taylorlaekeman/copper_chef/res/ac.png

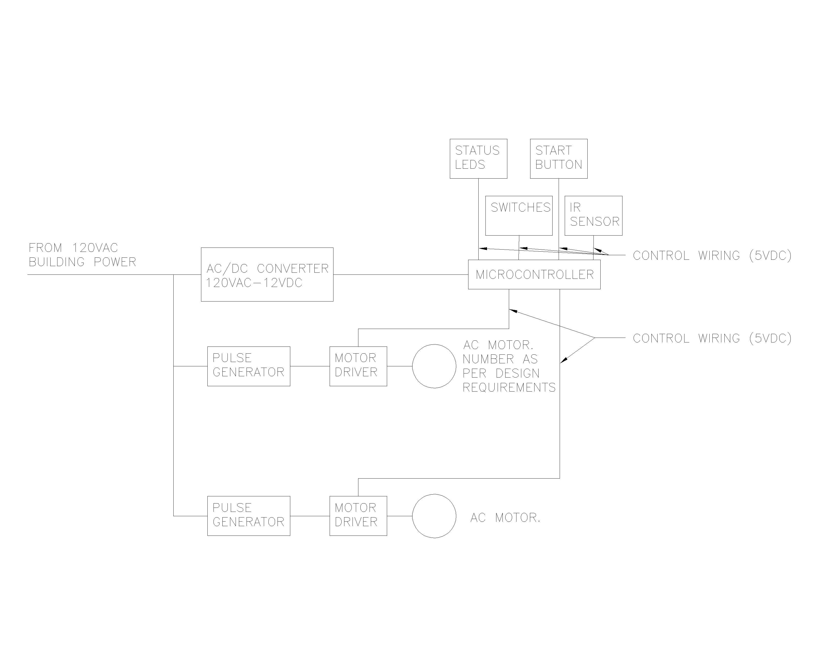
res/ac.png
