taylorlaekeman/copper_chef/res/belt.png

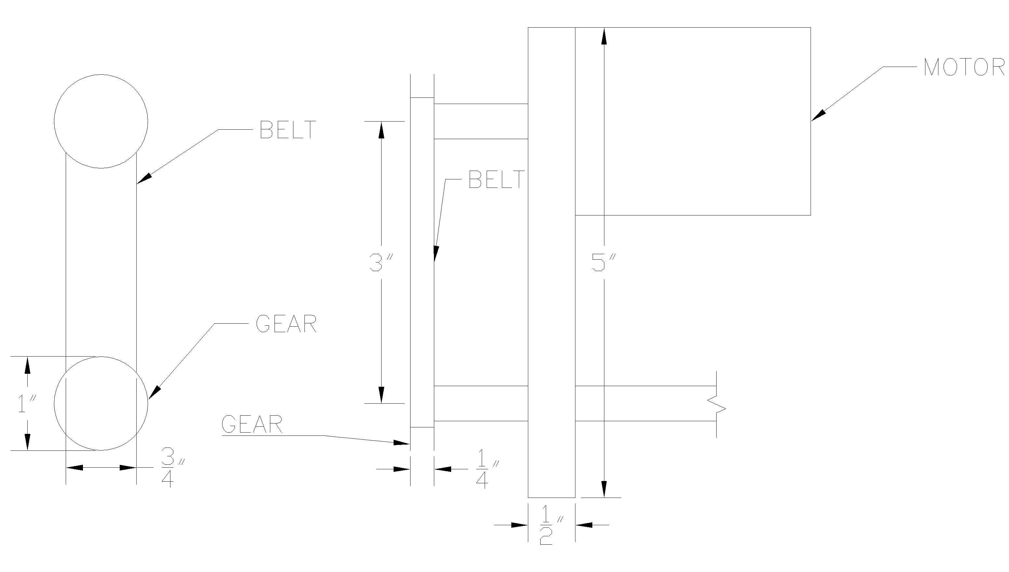
res/belt.png
