taylorlaekeman/copper_chef/res/bevel_gear.png

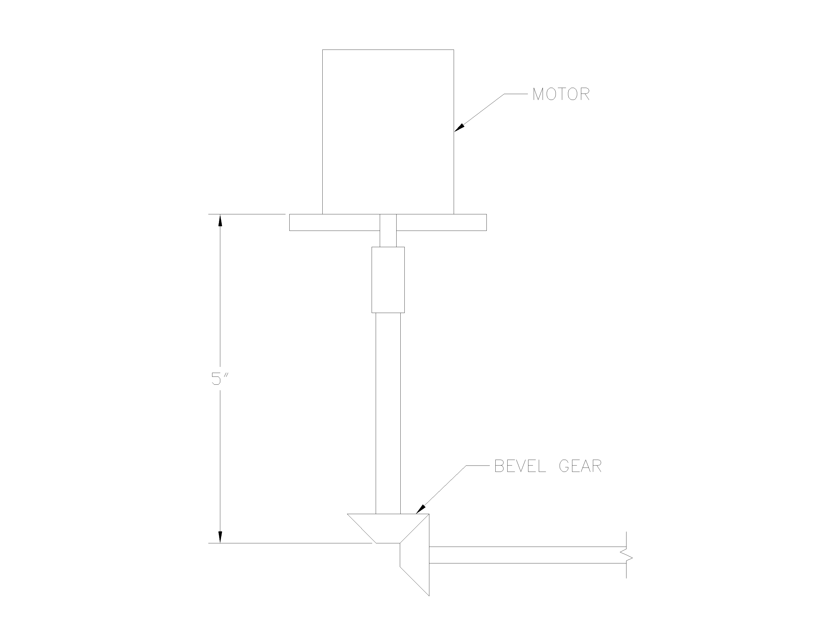
res/bevel_gear.png
