taylorlaekeman/copper_chef/res/cage.png

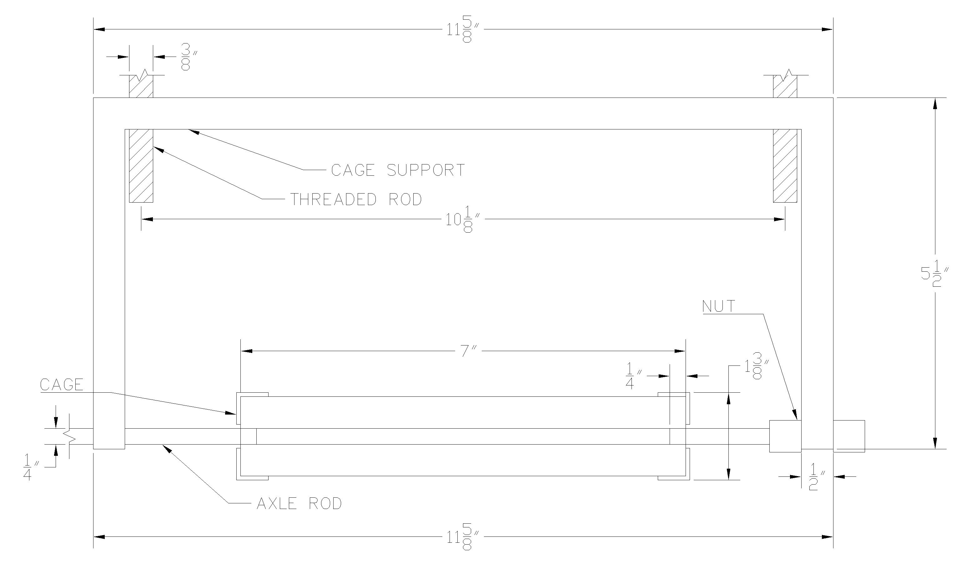
res/cage.png
