taylorlaekeman/copper_chef/res/cage_axle.png

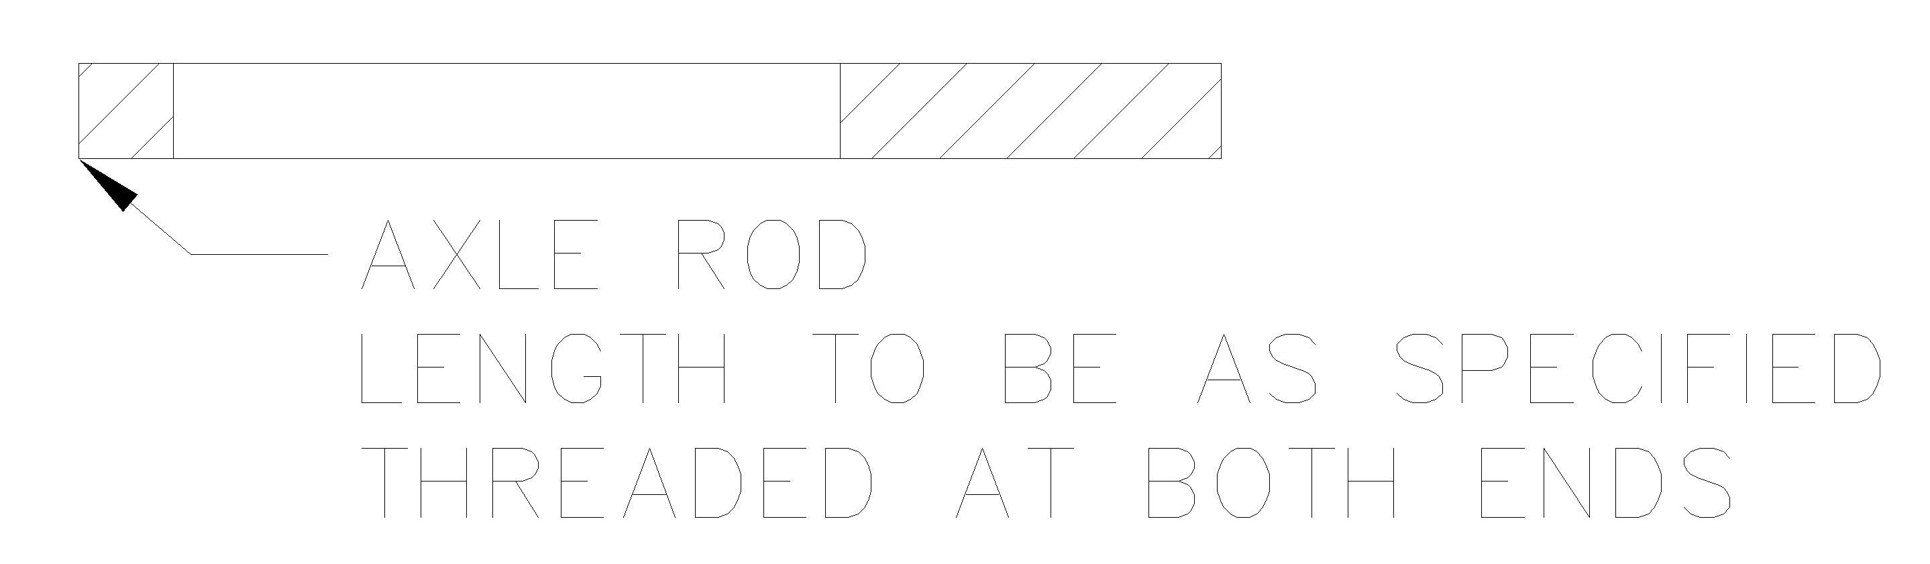
res/cage_axle.png
