taylorlaekeman/copper_chef/res/cage_ball_screw_adapter.png

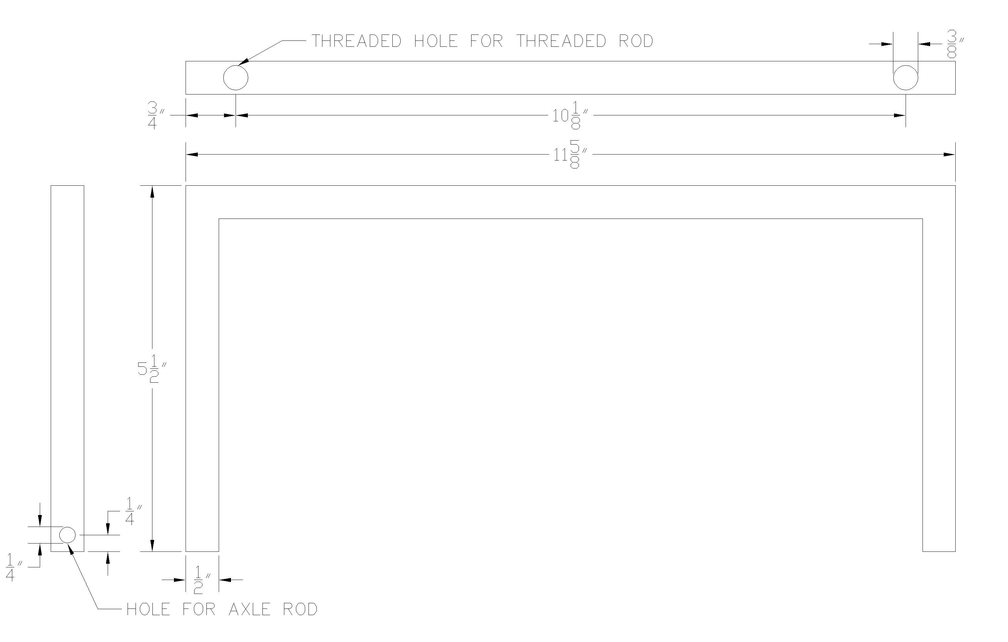
res/cage_ball_screw_adapter.png
