taylorlaekeman/copper_chef/res/cage_bar.png

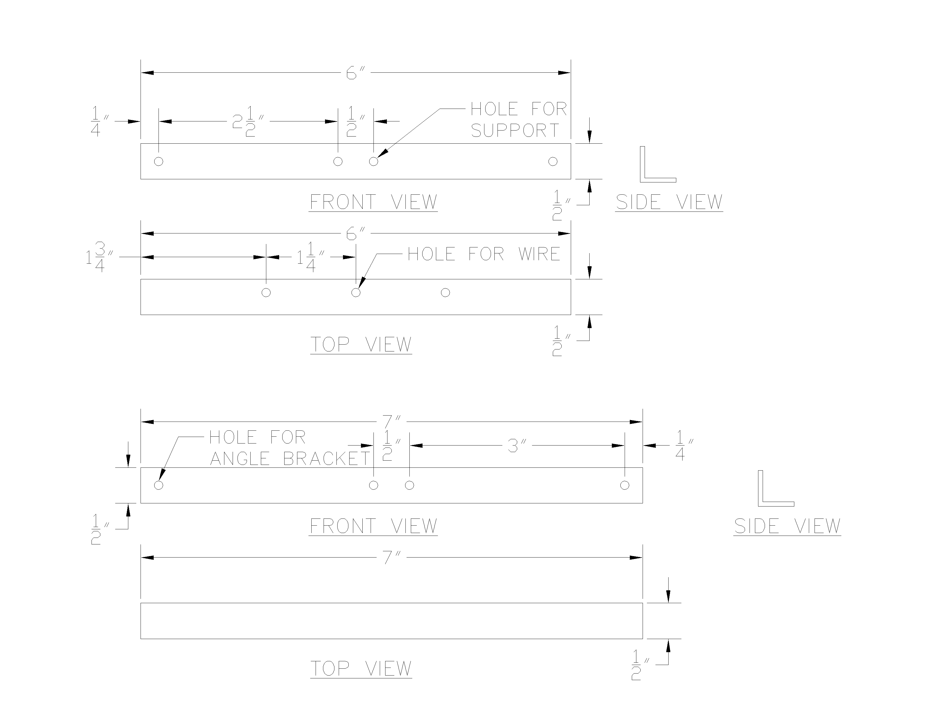
res/cage_bar.png
