taylorlaekeman/copper_chef/res/cage_basket.png

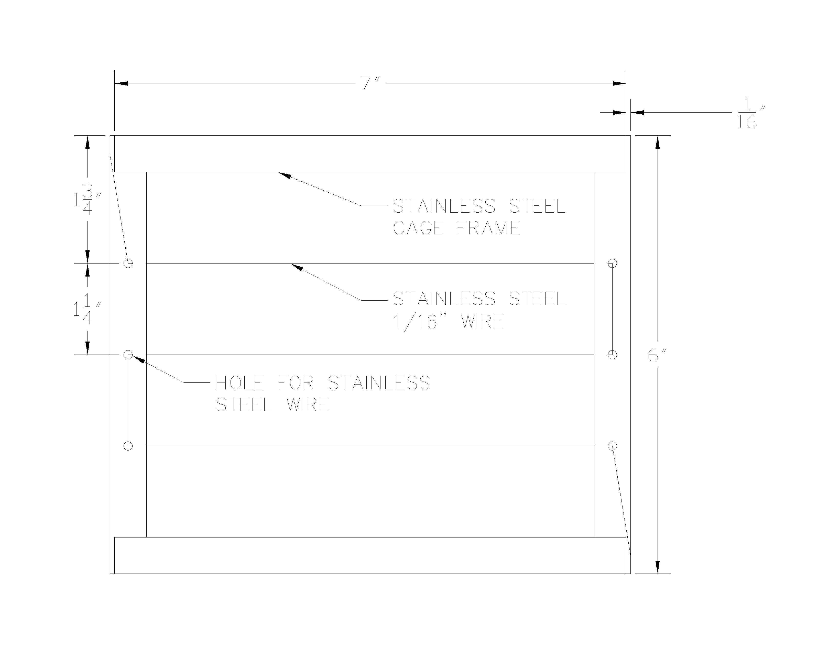
res/cage_basket.png
