taylorlaekeman/copper_chef/res/cage_coupling.png

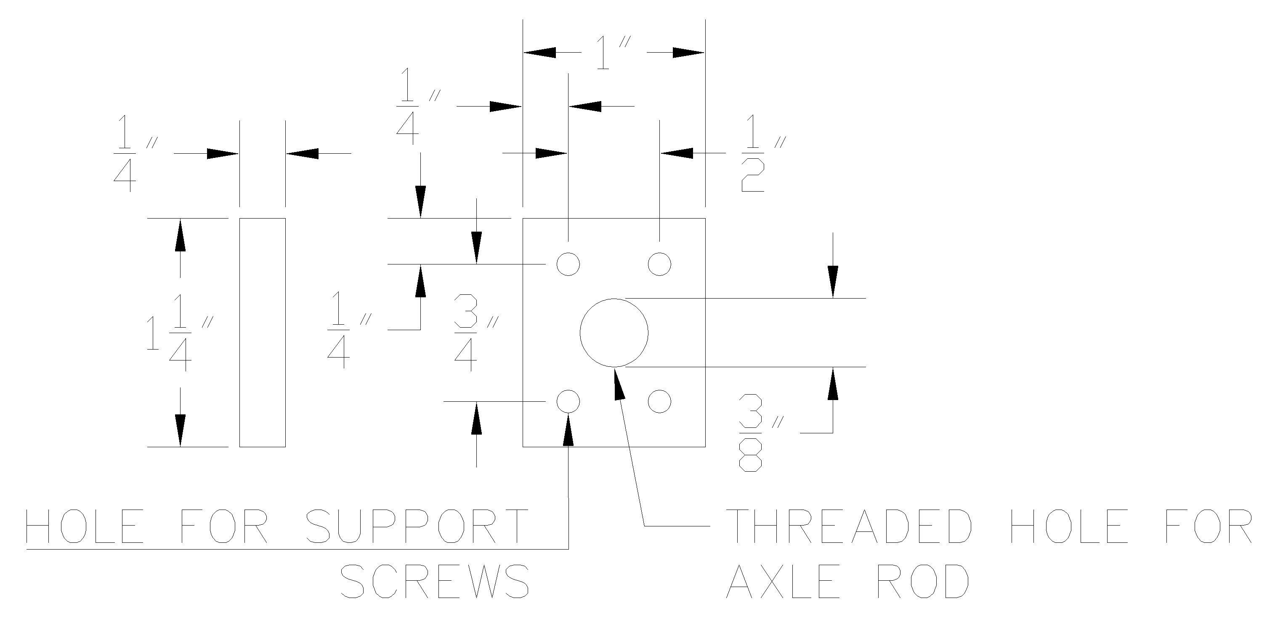
res/cage_coupling.png
