taylorlaekeman/copper_chef/res/dc.png

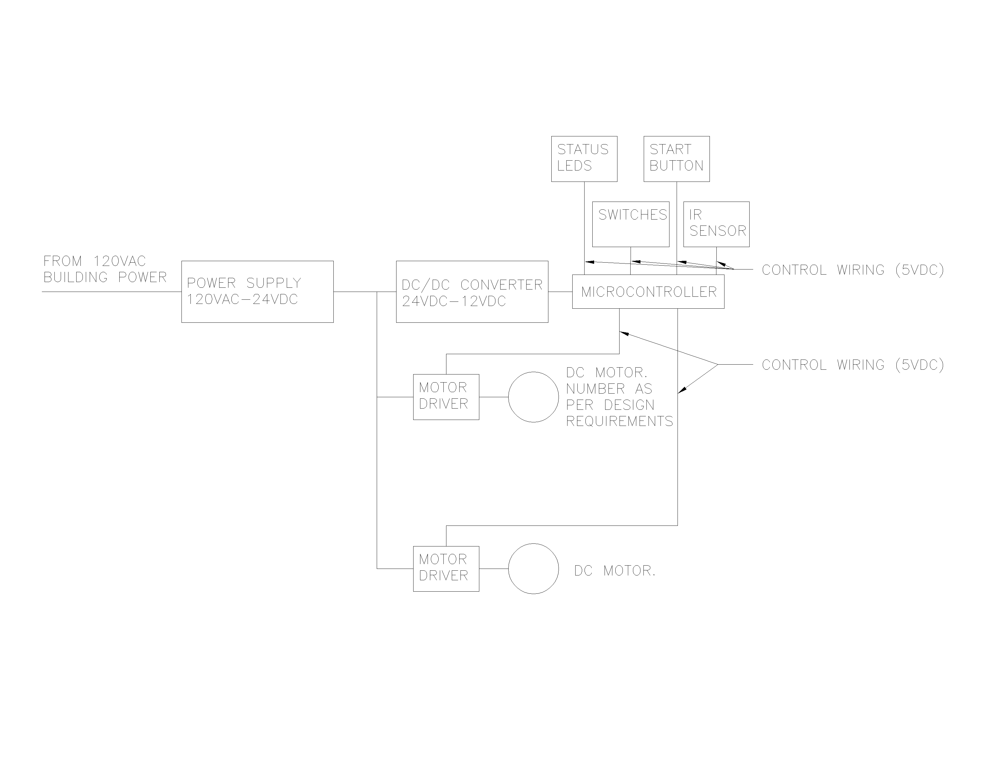
res/dc.png
