taylorlaekeman/copper_chef/res/gear_rack.png

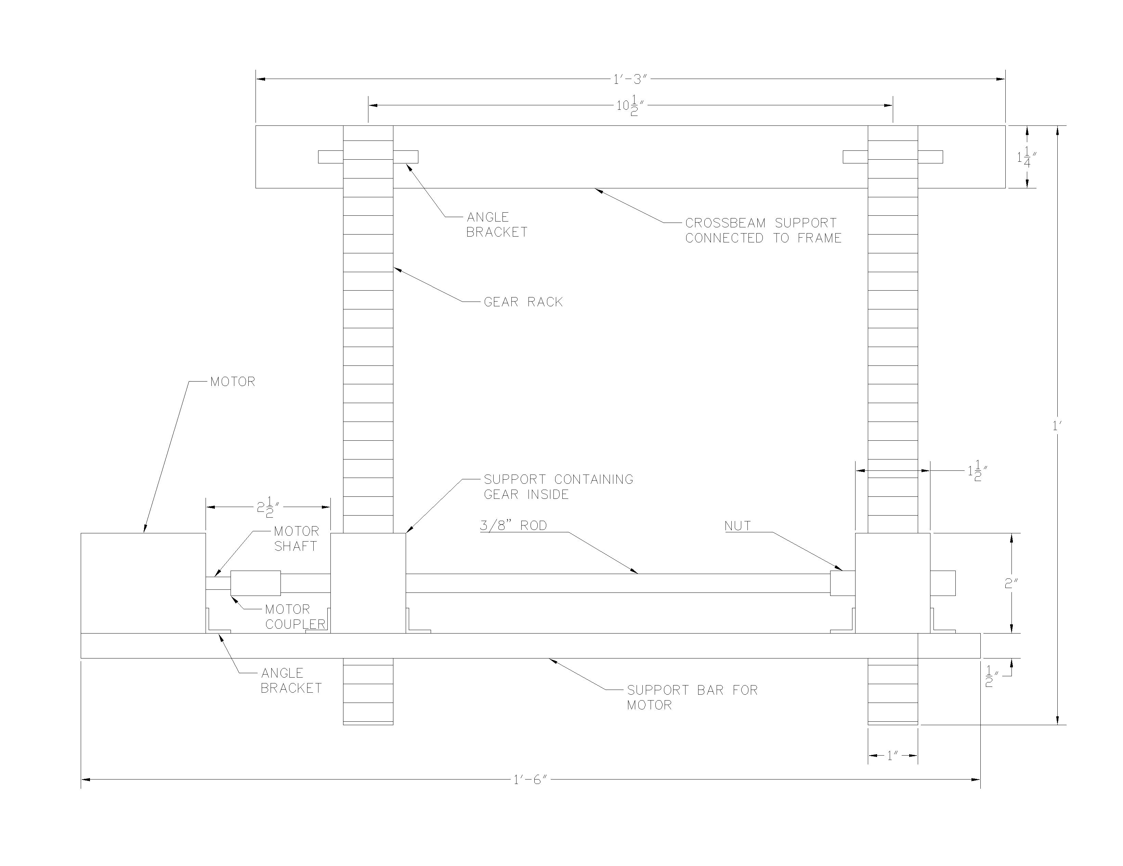
res/gear_rack.png
