taylorlaekeman/copper_chef/res/gear_rack_crossbeam.png

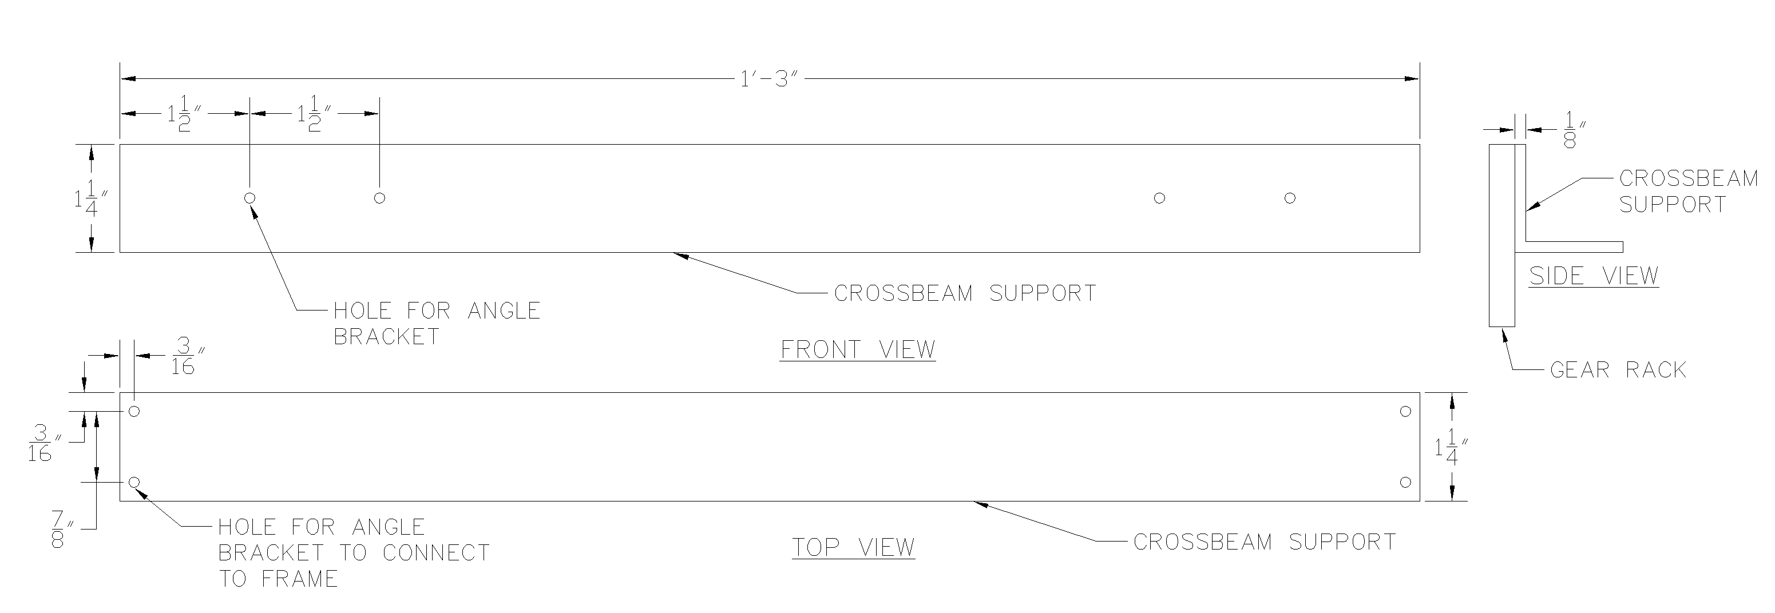
res/gear_rack_crossbeam.png
