taylorlaekeman/copper_chef/res/gear_rack_support.png

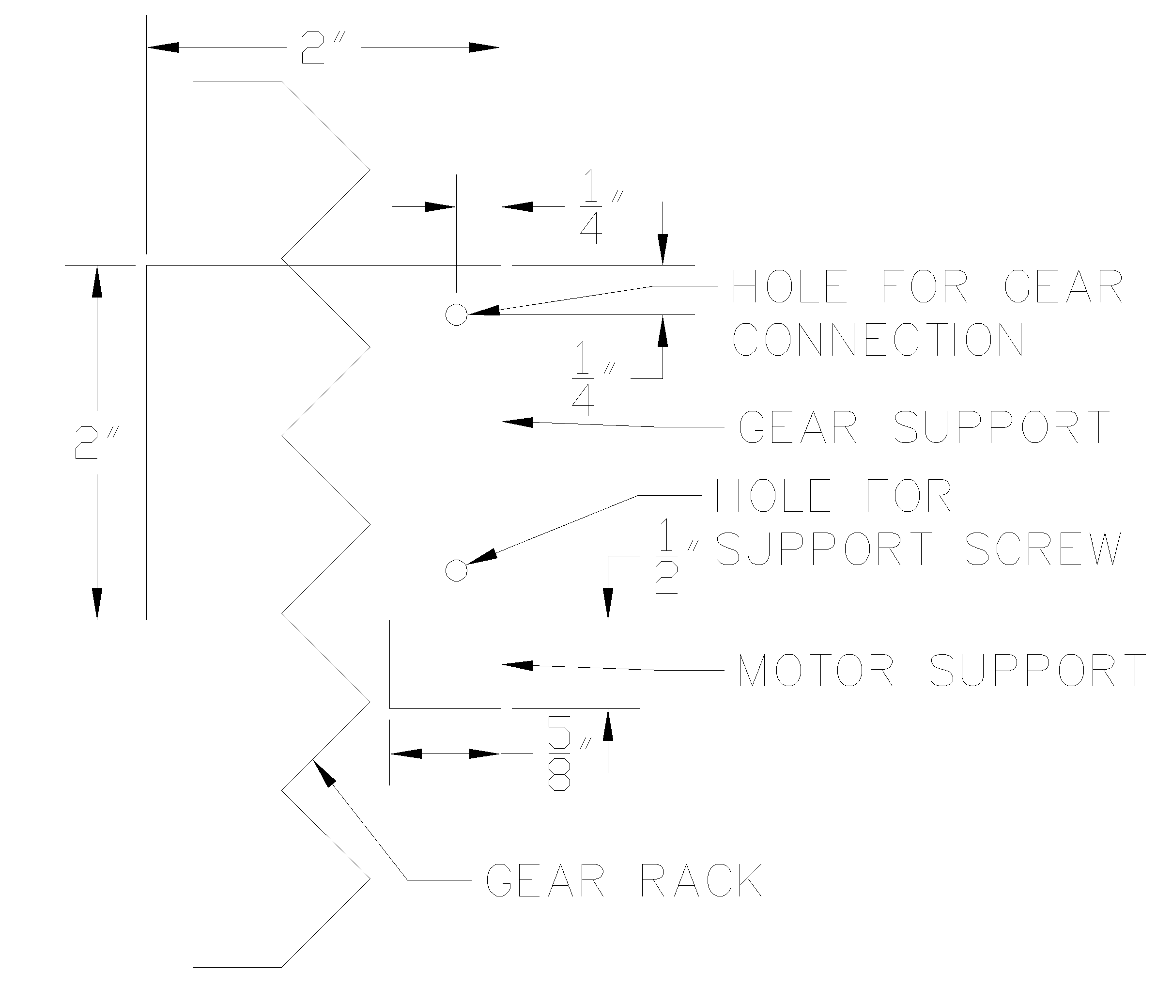
res/gear_rack_support.png
