taylorlaekeman/copper_chef/res/gear_rack_support_flat_bar.png

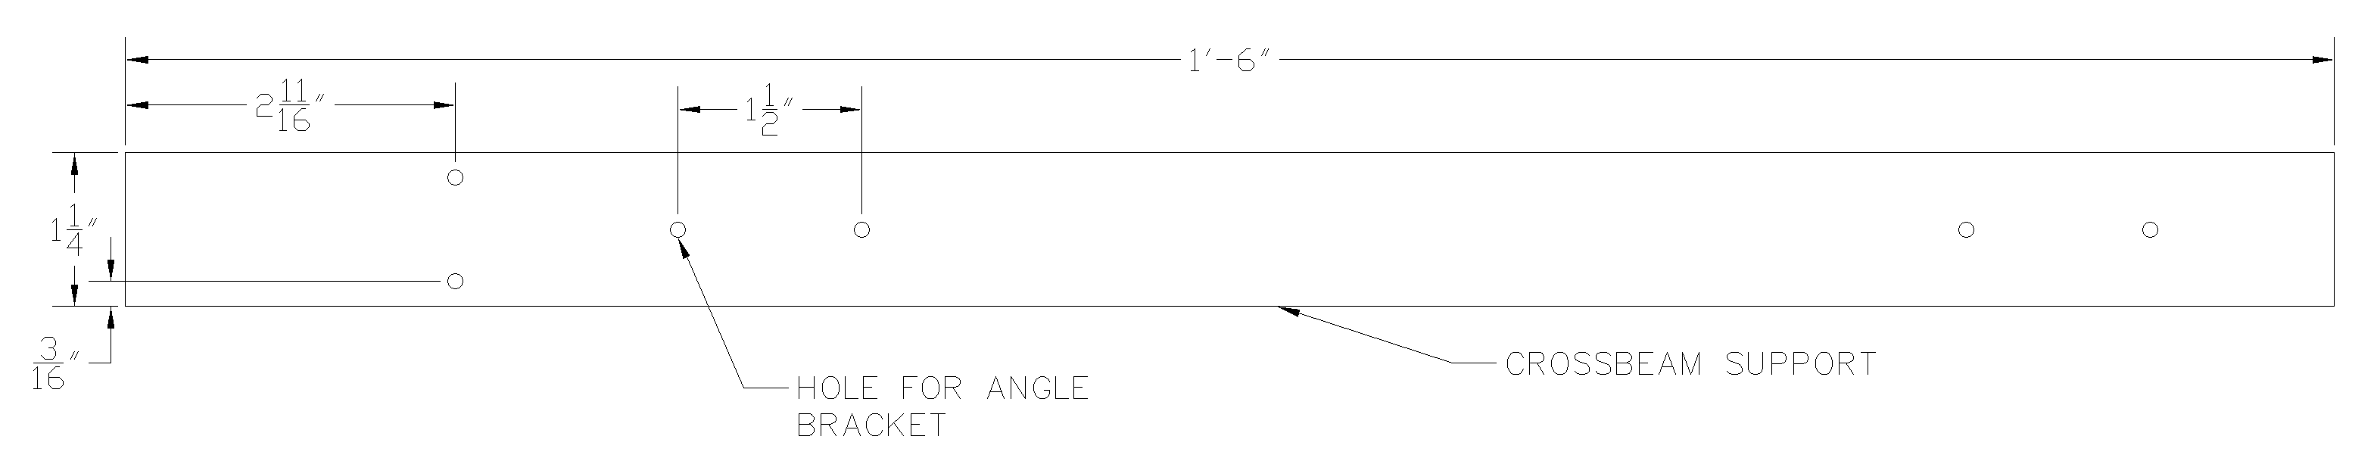
res/gear_rack_support_flat_bar.png
