taylorlaekeman/copper_chef/res/mesh.png

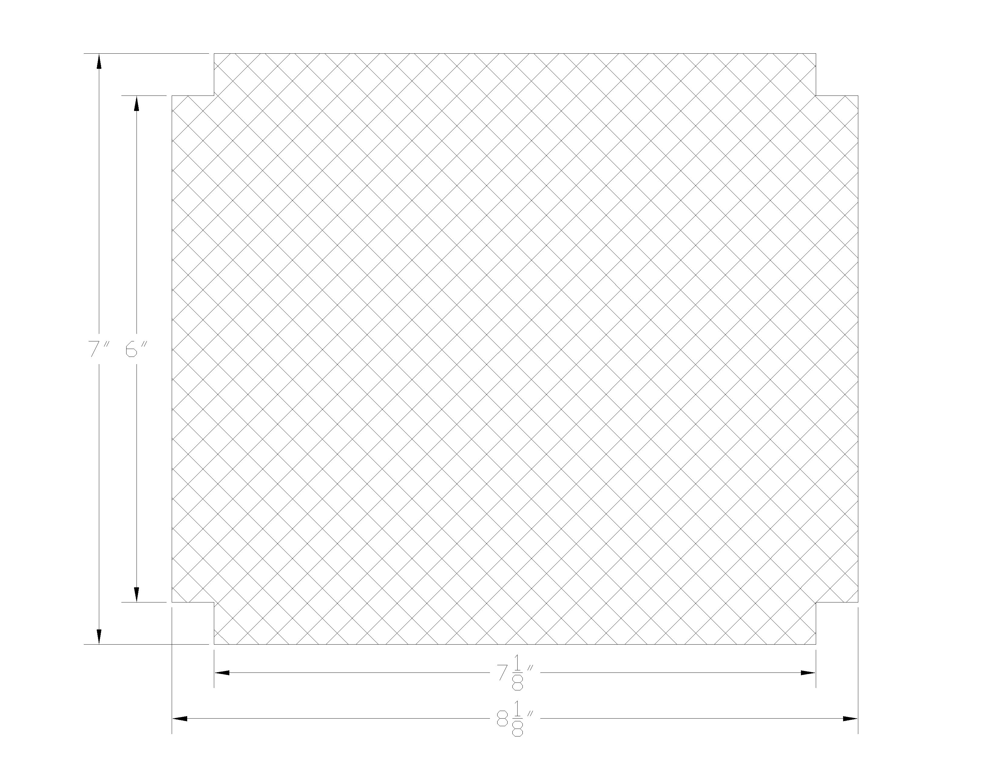
res/mesh.png
