taylorlaekeman/copper_chef/res/sensor.png

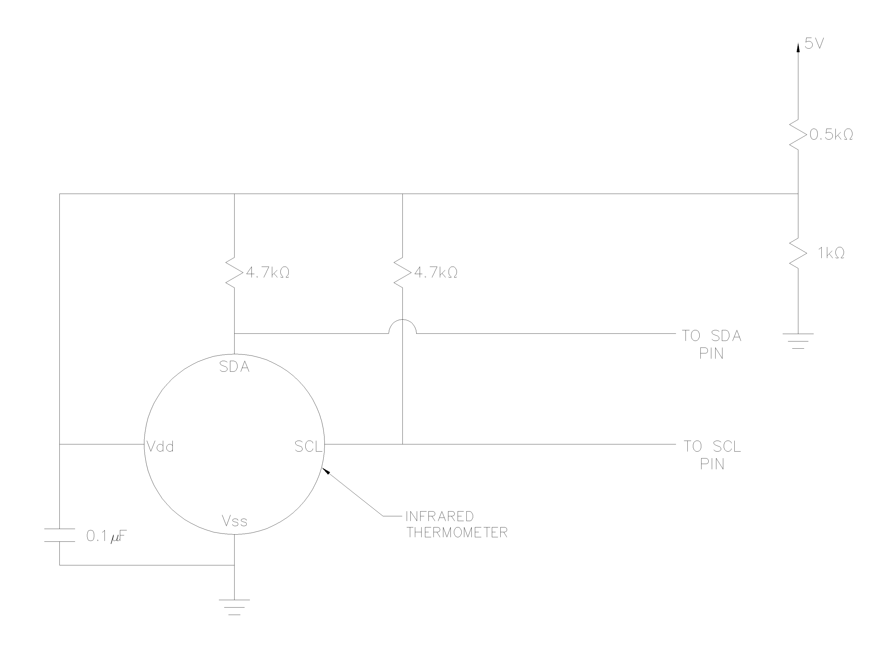
res/sensor.png
