taylorlaekeman/copper_chef/res/sensor_accuracy.png

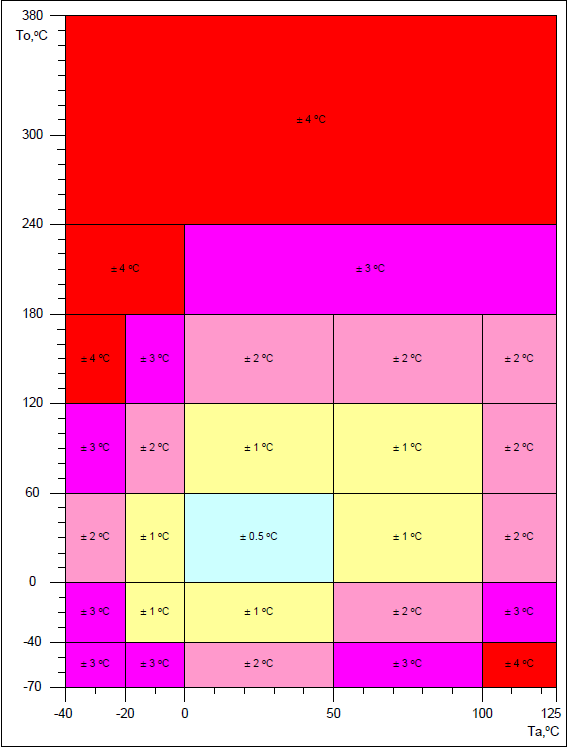
res/sensor_accuracy.png
