taylorlaekeman/copper_chef/res/spatula.png

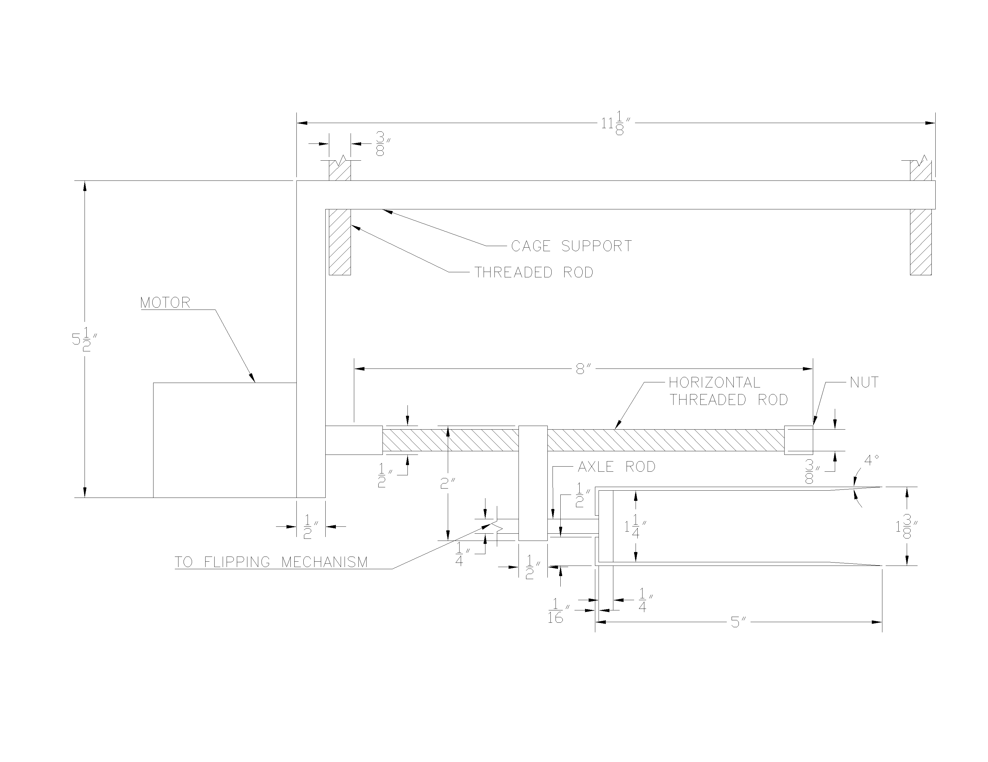
res/spatula.png
