taylorlaekeman/copper_chef/res/spatula_coupling.png

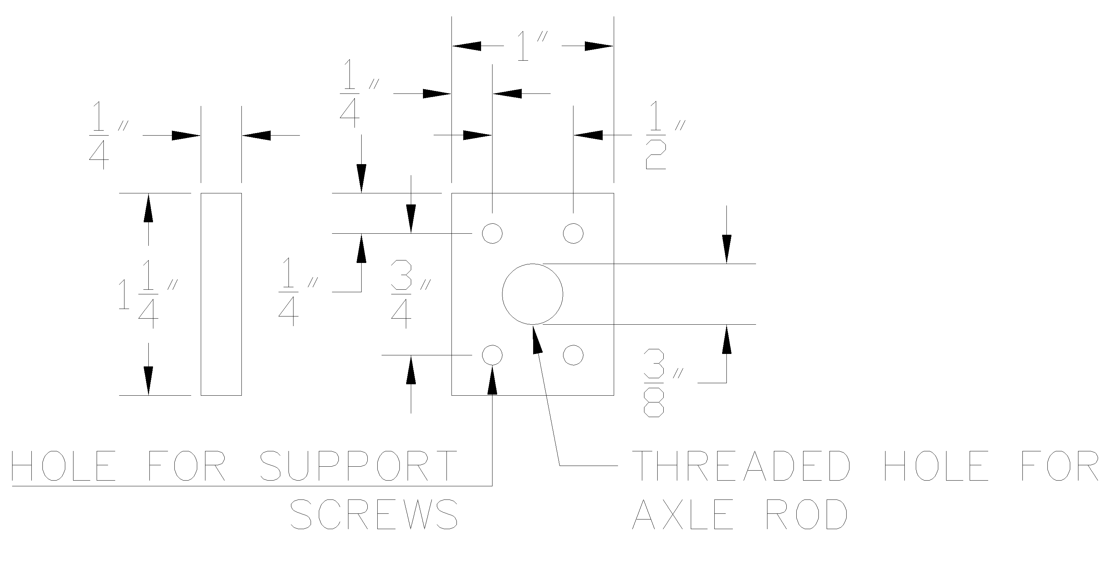
res/spatula_coupling.png
