taylorlaekeman/copper_chef/res/spatula_horizontal_coupling.png

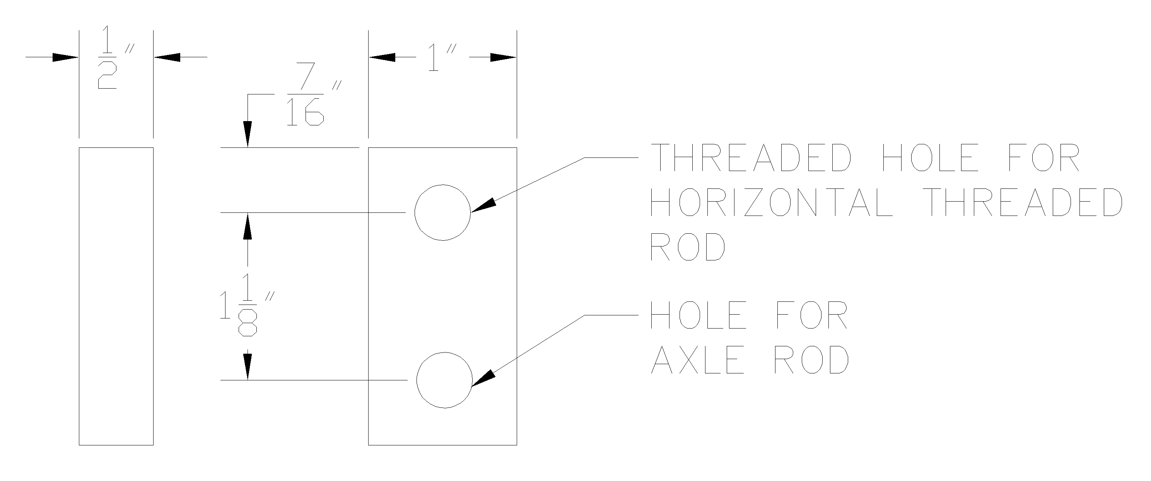
res/spatula_horizontal_coupling.png
