taylorlaekeman/copper_chef/res/spatula_plate.png

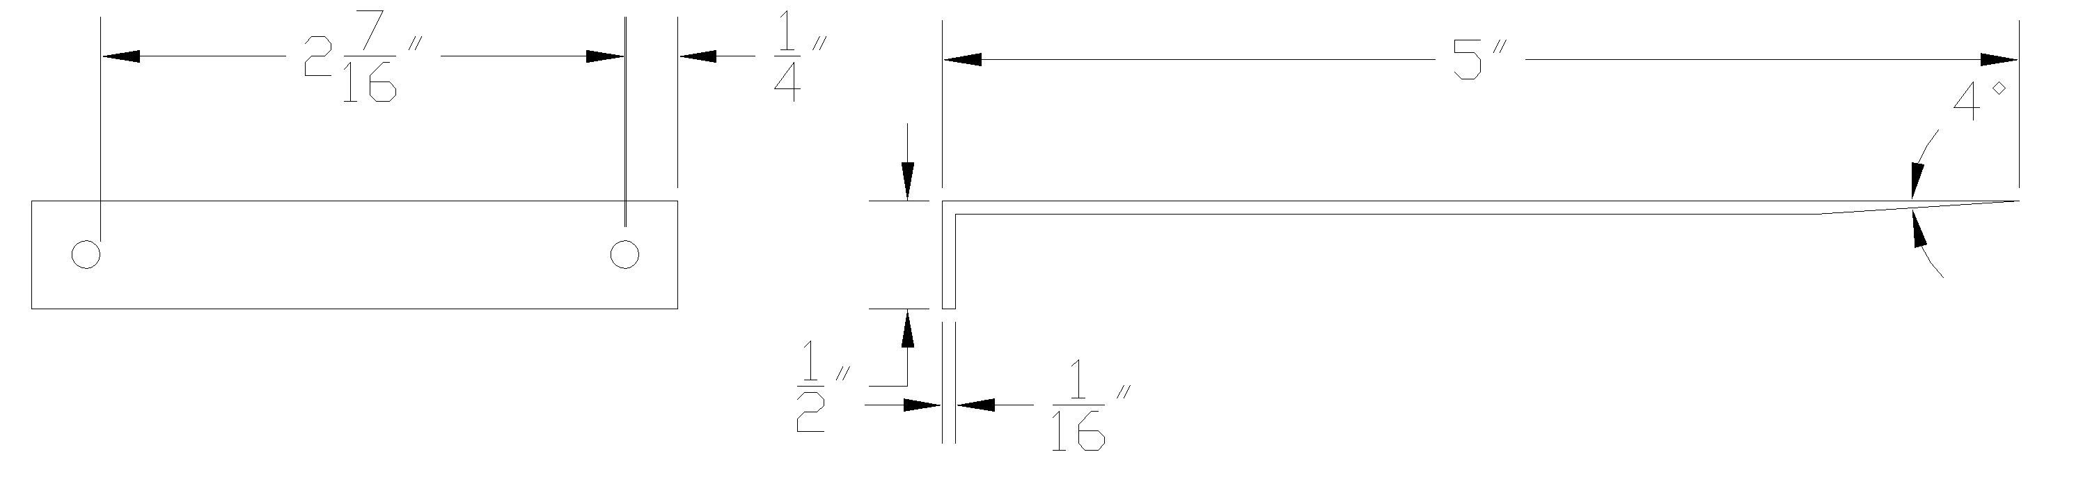
res/spatula_plate.png
