taylorlaekeman/copper_chef/res/spatula_support.png

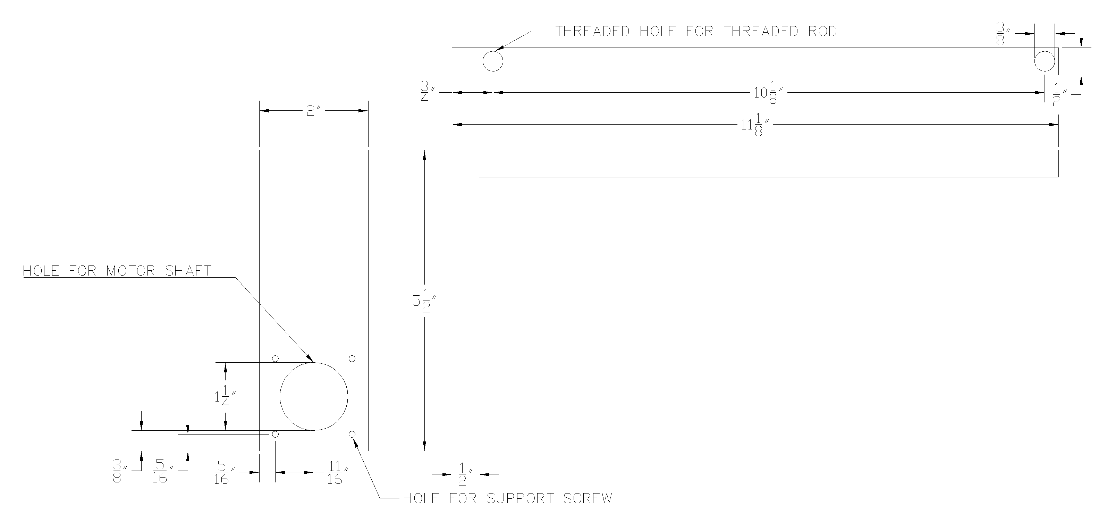
res/spatula_support.png
