taylorlaekeman/copper_chef/res/sprocket_and_chain.png

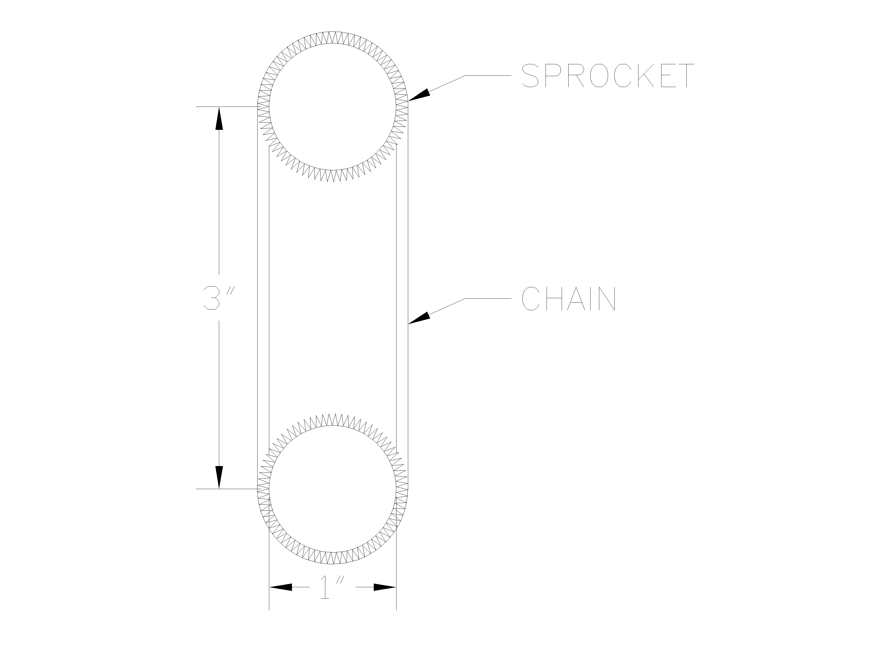
res/sprocket_and_chain.png
