taylorlaekeman/copper_chef/res/switch.png

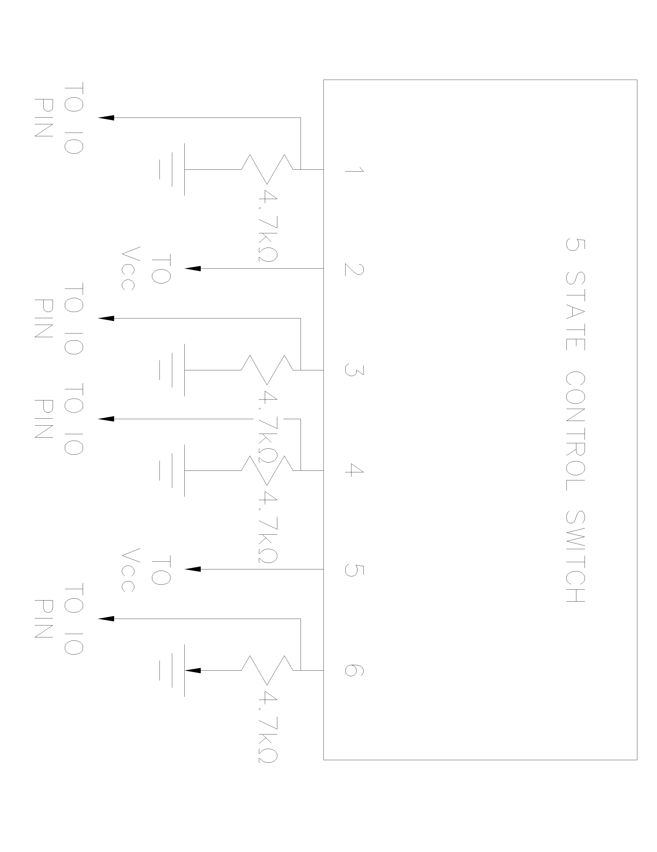
res/switch.png
