taylorlaekeman/copper_chef/res/threaded_rod.png

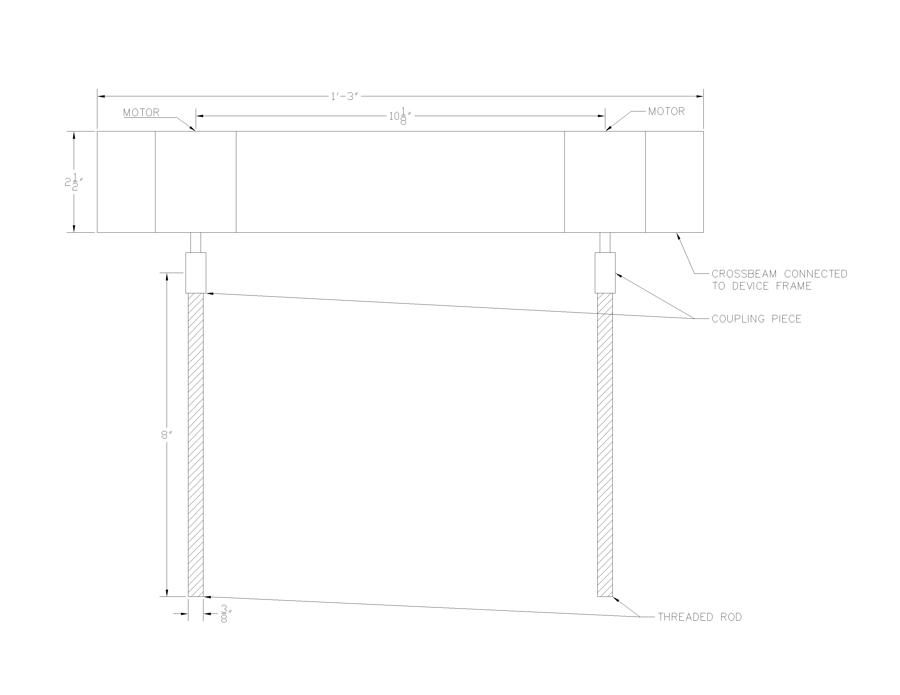
res/threaded_rod.png
