taylorlaekeman/copper_chef/res/threaded_rod_coupling.png

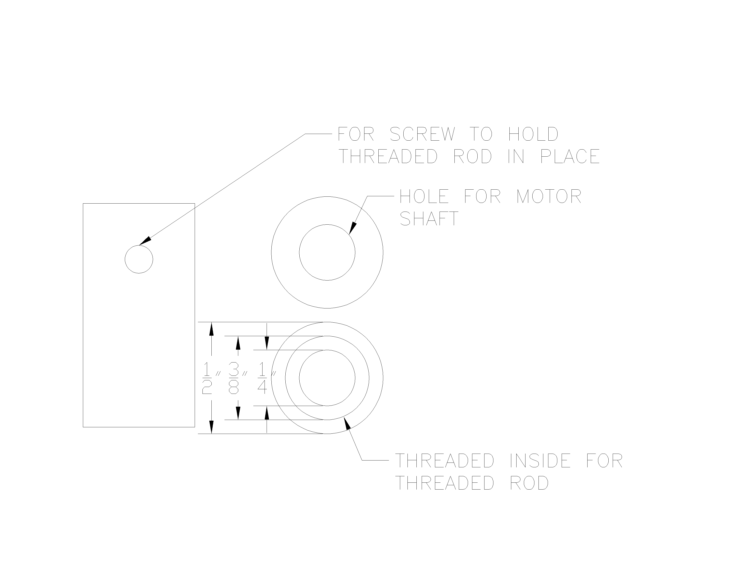
res/threaded_rod_coupling.png
