taylorlaekeman/copper_chef/res/threaded_rod_crossbeam.png

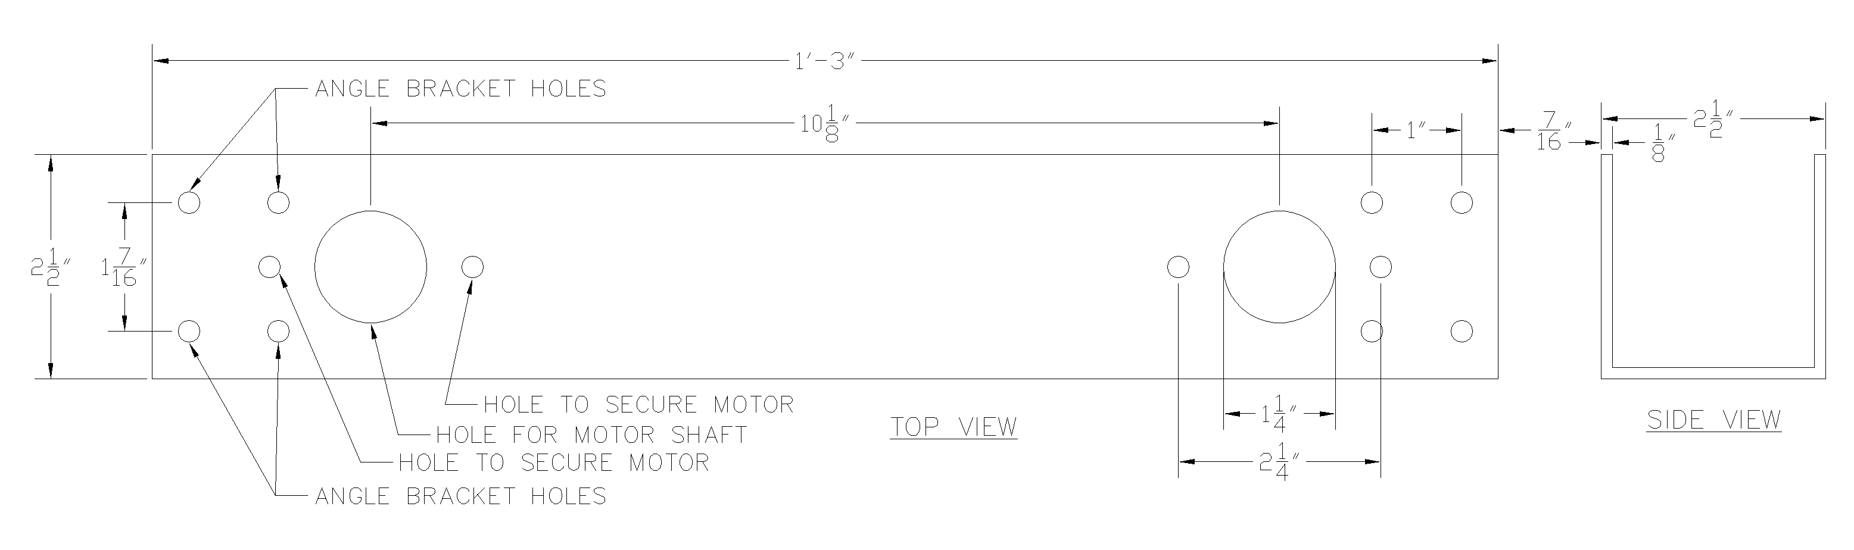
res/threaded_rod_crossbeam.png
